jfernandez84/miniteclado-macros/caja/Shell.3mf

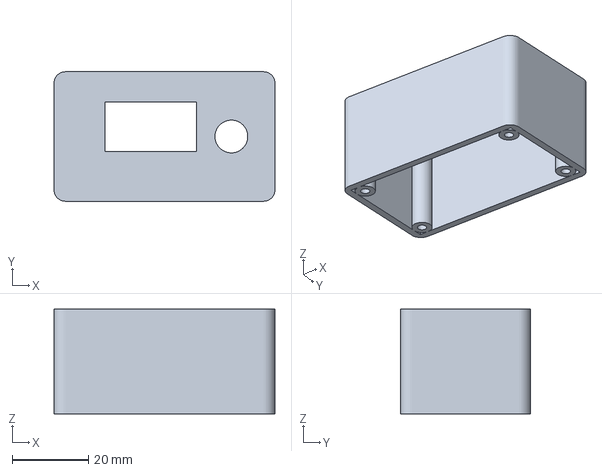
[picture p2: CAD file, 2026-10-24]
caja/Shell.3mf
58.0 x 34.0 x 27.5 mm
