jfernandez84/miniteclado-macros/caja/Lid.3mf

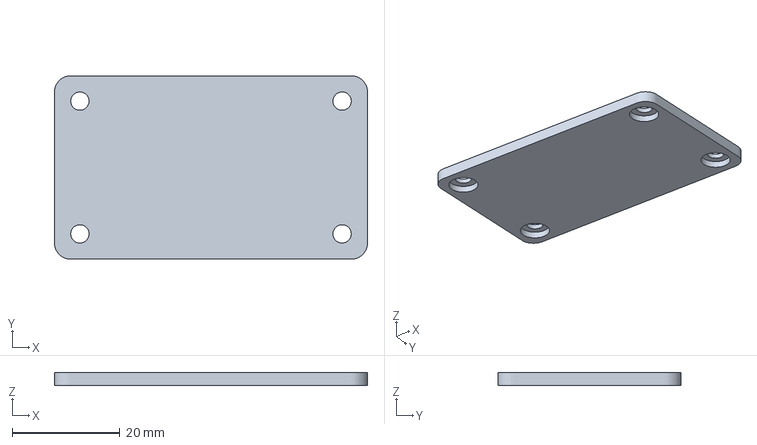
[picture p3: CAD file, 2026-10-24]
caja/Lid.3mf
58.0 x 34.0 x 2.40 mm
