jfernandez84/miniteclado-macros/(commit log)

2026-10-24 Miniteclado de macros: sketch Pro Micro, probador de teclas y README
2026-10-24 Añade la caja 3D (SolidCraft + 3MF), foto del montaje y sección en el README
    [Lid.3mf, Shell.3mf]
2026-10-24 Sketch en inglés y nuevo ítem Info con la pantalla de créditos
